MhmdKhalaily/GreenHouse-Project/מערכת החממה.jpg

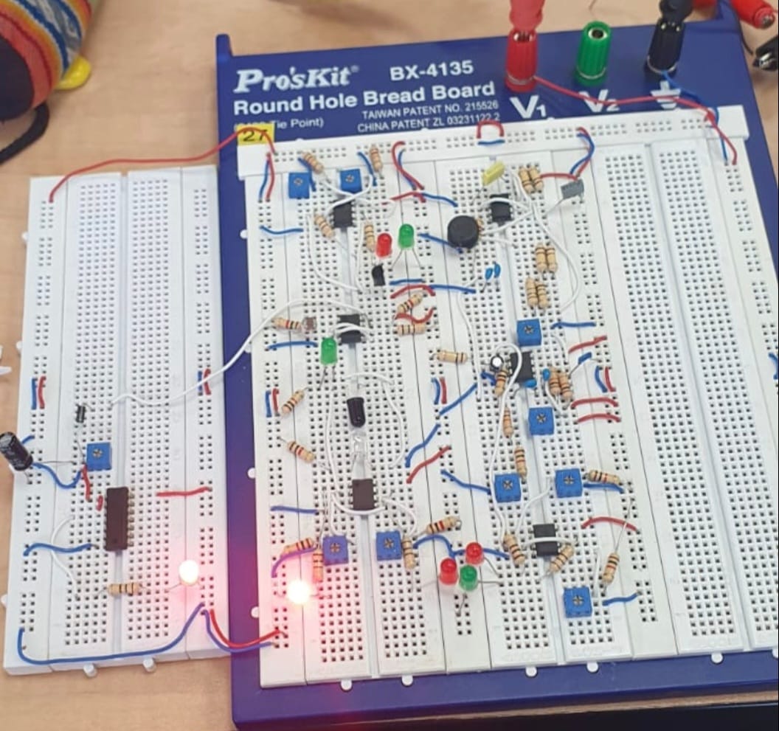
מערכת החממה.jpg
