MhmdKhalaily/GreenHouse-Project/תרשים בלוקים.png

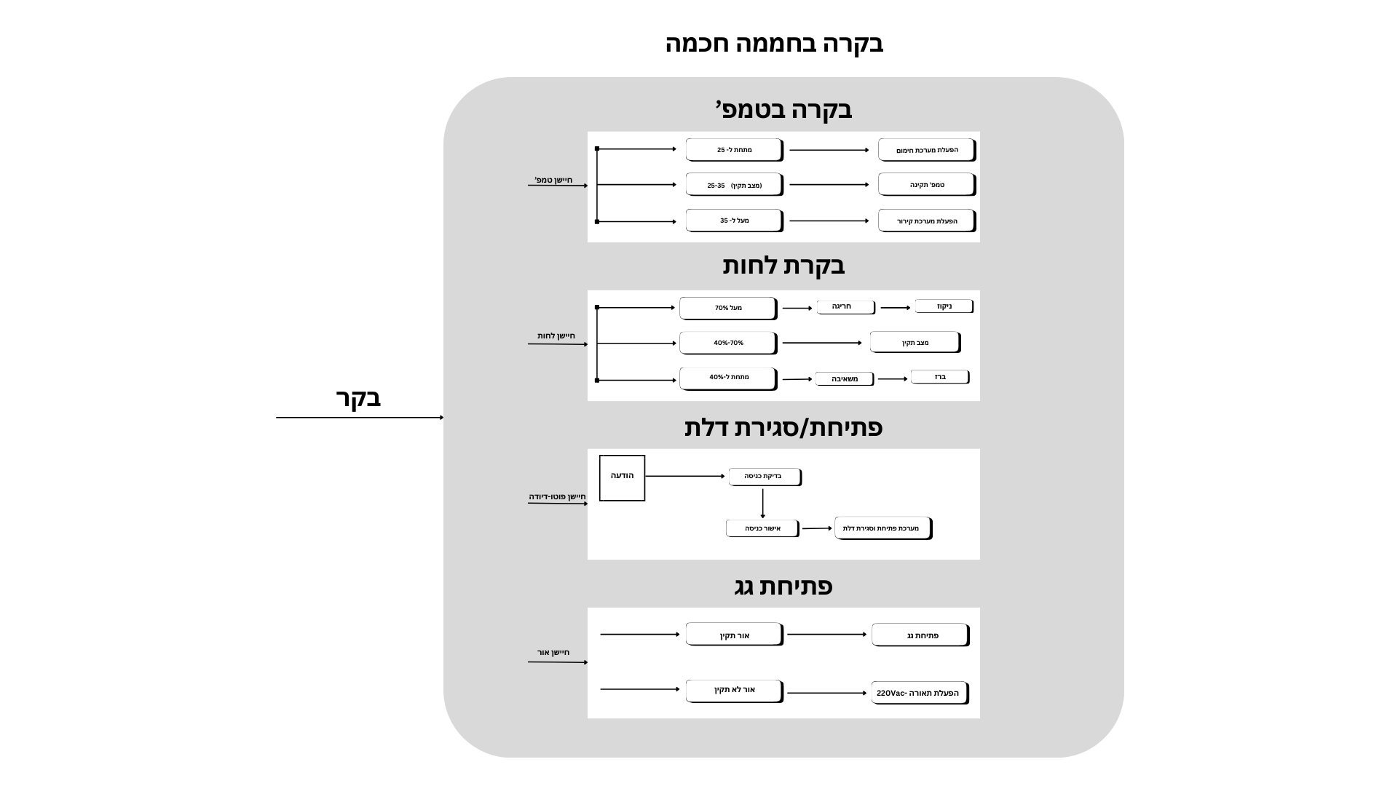
תרשים בלוקים.png
