MhmdKhalaily/GreenHouse-Project/(list of files, drawings)

Other design files:
בלוק-לחות.ms14
בקרת טמפ.ms14
חיישן לחות.ms14
